vinothus/mraf/hardware/bom.csv

Section | Ref | Item | Specification | Qty | Unit_INR | Total_INR | Source | Notes
Control | U1 | ESP32 DevKit V1 38-pin | ESP32-WROOM-32 dual-core Wi-Fi; 38-pin board | 1 | 450 | 450 | Robu / Amazon / Element14 | Buy a board with USB and 5 V input; CP2102 or CH340 is fine
Control | U2 | Relay module | 16-channel 5 V active-LOW with JD-VCC jumper | 1 | 850 | 850 | Ritchie Street / Robu | Remove JD-VCC jumper; logic side 3.3 V, coil side 5 V SMPS
Control | U3 | 5 V SMPS | 230 V AC input; 5 V 3 A enclosed SMPS | 1 | 550 | 550 | Ritchie Street / local electrical | Feeds relay coils only; add 1 A fuse and MOV
Control | U4 | 5 V buck converter | 9-24 V to 5 V 3 A buck module | 1 | 150 | 150 | Ritchie Street / Robu | Battery-backed controller rail
Control | U5 | LiFePO4 battery | 12.8 V 6 Ah LiFePO4 with BMS | 1 | 1700 | 1700 | Local battery shop / Amazon | Controller only; pump never runs on battery; LiFePO4 chemistry
Control | U6 | LiFePO4 charger | 14.6 V 2 A LiFePO4 charger | 1 | 700 | 700 | Local electrical / Amazon | Charge 14.4-14.6 V; float 13.5-13.6 V; LiFePO4 mode only
Control | U7 | Low-voltage disconnect | 12 V LVD module 11 V cutoff | 1 | 200 | 200 | Ritchie Street / Robu | Protects LiFePO4 pack from deep discharge; reconnect ~12.8 V
Control | U8 | RTC module | DS3231 with CR2032 backup | 1 | 120 | 120 | Ritchie Street / Robu | I2C address 0x68
Control | U9 | Current sensor | ACS712-30A Hall current module | 1 | 180 | 180 | Ritchie Street / Robu | Requires 2:1 divider before ESP32 ADC
Control | U10 | Tank-full safety float | NC float switch for 230 V contactor chain | 1 | 150 | 150 | Local hardware / Amazon | Hardwired safety; opens when tank is full
Control | U11 | Tank-full sense float | NO float switch for 3.3 V ESP32 input | 1 | 150 | 150 | Local hardware / Amazon | Separate low-voltage contact; do not mix with 230 V common
Control | U12 | Sump-dry safety float | NC float switch for 230 V contactor chain | 1 | 150 | 150 | Local hardware / Amazon | Hardwired safety; opens when sump is dry
Control | U13 | Sump-dry sense float | NO float switch for 3.3 V ESP32 input | 1 | 150 | 150 | Local hardware / Amazon | Separate low-voltage contact; do not mix with 230 V common
Control | U14 | Resistors and small parts | 100k 1/4 W; 22k 1/4 W; 10k 1/4 W; 10k 1/4 W matched pair | 1 | 100 | 100 | Ritchie Street | Battery divider; mains divider; float pull-ups; ACS divider
Control | U15 | Fuse holder and fuse | 5x20 mm panel holder + 1 A slow-blow | 1 | 80 | 80 | Local electrical | Protects control circuit
Control | U16 | RC snubber / MOV | RC snubber 100 ohm/0.1 uF + MOV 275 V | 2 | 60 | 120 | Local electrical | Across contactor coil and SMPS input
Control | U17 | Terminal blocks | DIN-rail screw terminals 2.5 mm2 | 1 | 300 | 300 | Local electrical | Use separate mains and signal terminals
Control | U18 | DIN rail and wire duct | 35 mm DIN rail 1 m + 25 mm slotted duct 1 m | 1 | 500 | 500 | Local electrical | Cut to enclosure
Control | U19 | Ferrules and lugs | Assorted bootlace ferrules and ring lugs | 1 | 200 | 200 | Local electrical | Crimp every stranded wire
Control | U20 | Labels and ties | Cable labels; zip ties; heat-shrink | 1 | 200 | 200 | Local electrical | Label both ends of every core
Power | P1 | 3-pole isolator | 32 A lockable 3-pole + N isolator | 1 | 450 | 450 | Local electrical | Upstream of panel; lockable for service
Power | P2 | 4-pole RCCB | 40 A 30 mA 4-pole RCCB | 1 | 1800 | 1800 | Local electrical | Recommended safety item; 100 mA may be needed for nuisance tripping
Power | P3 | 3-pole MCB | 16 A C or D curve 3-pole MCB | 1 | 450 | 450 | Local electrical | Motor-rated breaker or MPCB preferred
Power | P4 | Contactor | 9 A AC-3 3-pole contactor; coil 415 V or 230 V | 1 | 900 | 900 | Local electrical | Match coil voltage to control circuit
Power | P5 | Auxiliary contact | NO/NC front-mount aux contact for contactor | 1 | 250 | 250 | Local electrical | Used for HAND latch/status
Power | P6 | Thermal overload | 5.5-8 A motor overload relay | 1 | 700 | 700 | Local electrical | Set to motor FLC ~7 A
Power | P7 | Phase-failure relay | 3-phase phase-failure/phase-sequence relay | 1 | 650 | 650 | Local electrical | Strongly recommended; NC contact in safety chain
Power | P8 | Control MCB | 6 A single-pole MCB | 1 | 250 | 250 | Local electrical | Protects 230 V control circuit
Power | P9 | E-stop | Latching mushroom E-stop; NC contact | 1 | 250 | 250 | Local electrical | In series with safety chain
Power | P10 | Pushbuttons | Start NO + Stop NC; 22 mm | 2 | 120 | 240 | Local electrical | HAND maintenance circuit
Power | P11 | Selector switch | Auto/Off/Hand 3-position selector | 1 | 180 | 180 | Local electrical | Separate contacts for AUTO and HAND
Power | P12 | Panel lamps | 22 mm lamps: R/Y/B/ON/TRIP | 5 | 60 | 300 | Local electrical | Phase indication and status
Power | P13 | IP65 enclosure | 500 x 400 x 200 mm polycarbonate/metal | 1 | 900 | 900 | Local electrical | Lockable; cable glands at bottom
Power | P14 | 4-core pump cable | 2.5 mm2 Cu 4-core armored cable | 20 | 85 | 1700 | Local electrical | 4 mm2 for runs over ~30 m; price per metre
Power | P15 | Control wire | 1.5 mm2 Cu flexible wire | 30 | 25 | 750 | Local electrical | Price per metre; use ferrules
Power | P16 | Earth wire | 1.5 mm2 green/yellow Cu | 10 | 30 | 300 | Local electrical | Bond enclosure, DIN rail, motor frame
Power | P17 | Panel wire and lugs | 2.5 mm2 panel wire; assorted lugs | 1 | 700 | 700 | Local electrical | Three-phase and neutral links
Misc | M1 | ESP32 mounting | Standoffs | perfboard | project box | 1 | 150 | 150 | Local electronics | No custom PCB needed
Misc | M2 | Cable glands | PG7/PG9/PG16 assorted glands | 1 | 200 | 200 | Local electrical | Separate mains and sensor entries
Misc | M3 | Silica gel / vent | Small vent and silica pack | 1 | 100 | 100 | Local electrical | Reduce condensation; do not seal battery compartment
