vinothus/mraf/(commit log)

2026-11-08 Initial commit: MRAF ESP32 farm controller, server, simulator and docs
    [bom.csv]
2026-11-08 Add Zephyr RTOS port with native and ESP32 targets
2026-11-11 Update demo recordings and add ESP32 demo recording script
